LvQingGuo/NB-Locator/NB-Locator.ioc

Mcu.UserName=STM32L031F6Px
PA0-CK_IN.GPIO_Label=NB_PSM
PA0-CK_IN.Signal=GPIO_Output
PA1.GPIO_Label=BAT_ADC_EN
PA1.Signal=GPIO_Output
PA10.Signal=USART2_RX
PA13.Signal=SYS_SWDIO
PA14.Signal=SYS_SWCLK
PA2.Signal=LPUART1_TX
PA3.Signal=LPUART1_RX
PA4.Signal=ADC_IN4
PA5.GPIO_Label=NB_RST
PA5.Signal=GPIO_Output
PA6.GPIO_Label=NB_PWR
PA6.Signal=GPIO_Output
PA7.GPIO_Label=PWR_EN
PA7.Signal=GPIO_Output
PA9.Signal=USART2_TX
PB1.GPIO_Label=SHUT_DOWN
PB1.Signal=GPIO_Input
PC15-OSC32_OUT.GPIO_Label=PWR_LED
PC15-OSC32_OUT.Signal=GPIO_Output
